Jeff-Birt/TRS-80_M100_SRAM_Tester/Chip_Numbers.JPG

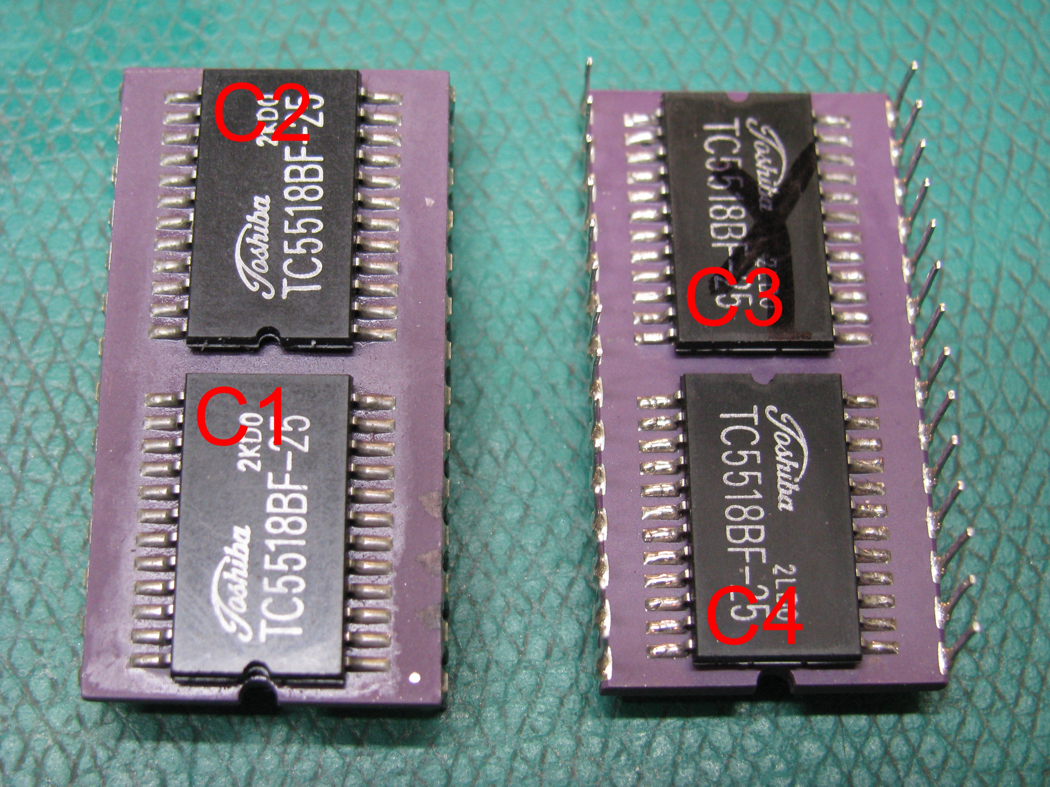
Chip_Numbers.JPG
