Jeff-Birt/TRS-80_M100_SRAM_Tester/README.md

# TRS-80_M100_SRAM_Tester
Uses an Arduino Mega to test TRS-80 SRAM modules.

Not only useful for the intended purpose but can also be used as a template for
building a test fixture for other devices. Demonstrates a basic user interface
using three push buttons and OLED display. Shows Ardunio Port/Pin manipualtion
done by abstracting the bit twiddling functions.

This is hardware released into the public domain.

Anyone is free to copy, modify, use, sell products made from this design.
Please be nice attribute the design to its source, i.e. HEY_BIRT!
If you offer it for sale do so at a reasonable price, don't gouge
folks for somethig you did not design.

THE DESIGN IS PROVIDED "AS IS", WITHOUT WARRANTY OF ANY KIND,
EXPRESS OR IMPLIED, INCLUDING BUT NOT LIMITED TO THE WARRANTIES OF
MERCHANTABILITY, FITNESS FOR A PARTICULAR PURPOSE AND NONINFRINGEMENT.
IN NO EVENT SHALL THE AUTHORS BE LIABLE FOR ANY CLAIM, DAMAGES OR
OTHER LIABILITY, WHETHER IN AN ACTION OF CONTRACT, TORT OR OTHERWISE,
ARISING FROM, OUT OF OR IN CONNECTION WITH THE SOFTWARE OR THE USE OR
OTHER DEALINGS IN THE SOFTWARE.
