Jeff-Birt/TRS-80_M100_SRAM_Tester/Arduino MEGA Tester Schematic/TRS-80_M100_SRAM_Module_Tester_Schematic.pdf

# DC-DC Converter

GND V⁺ | +5V -5V

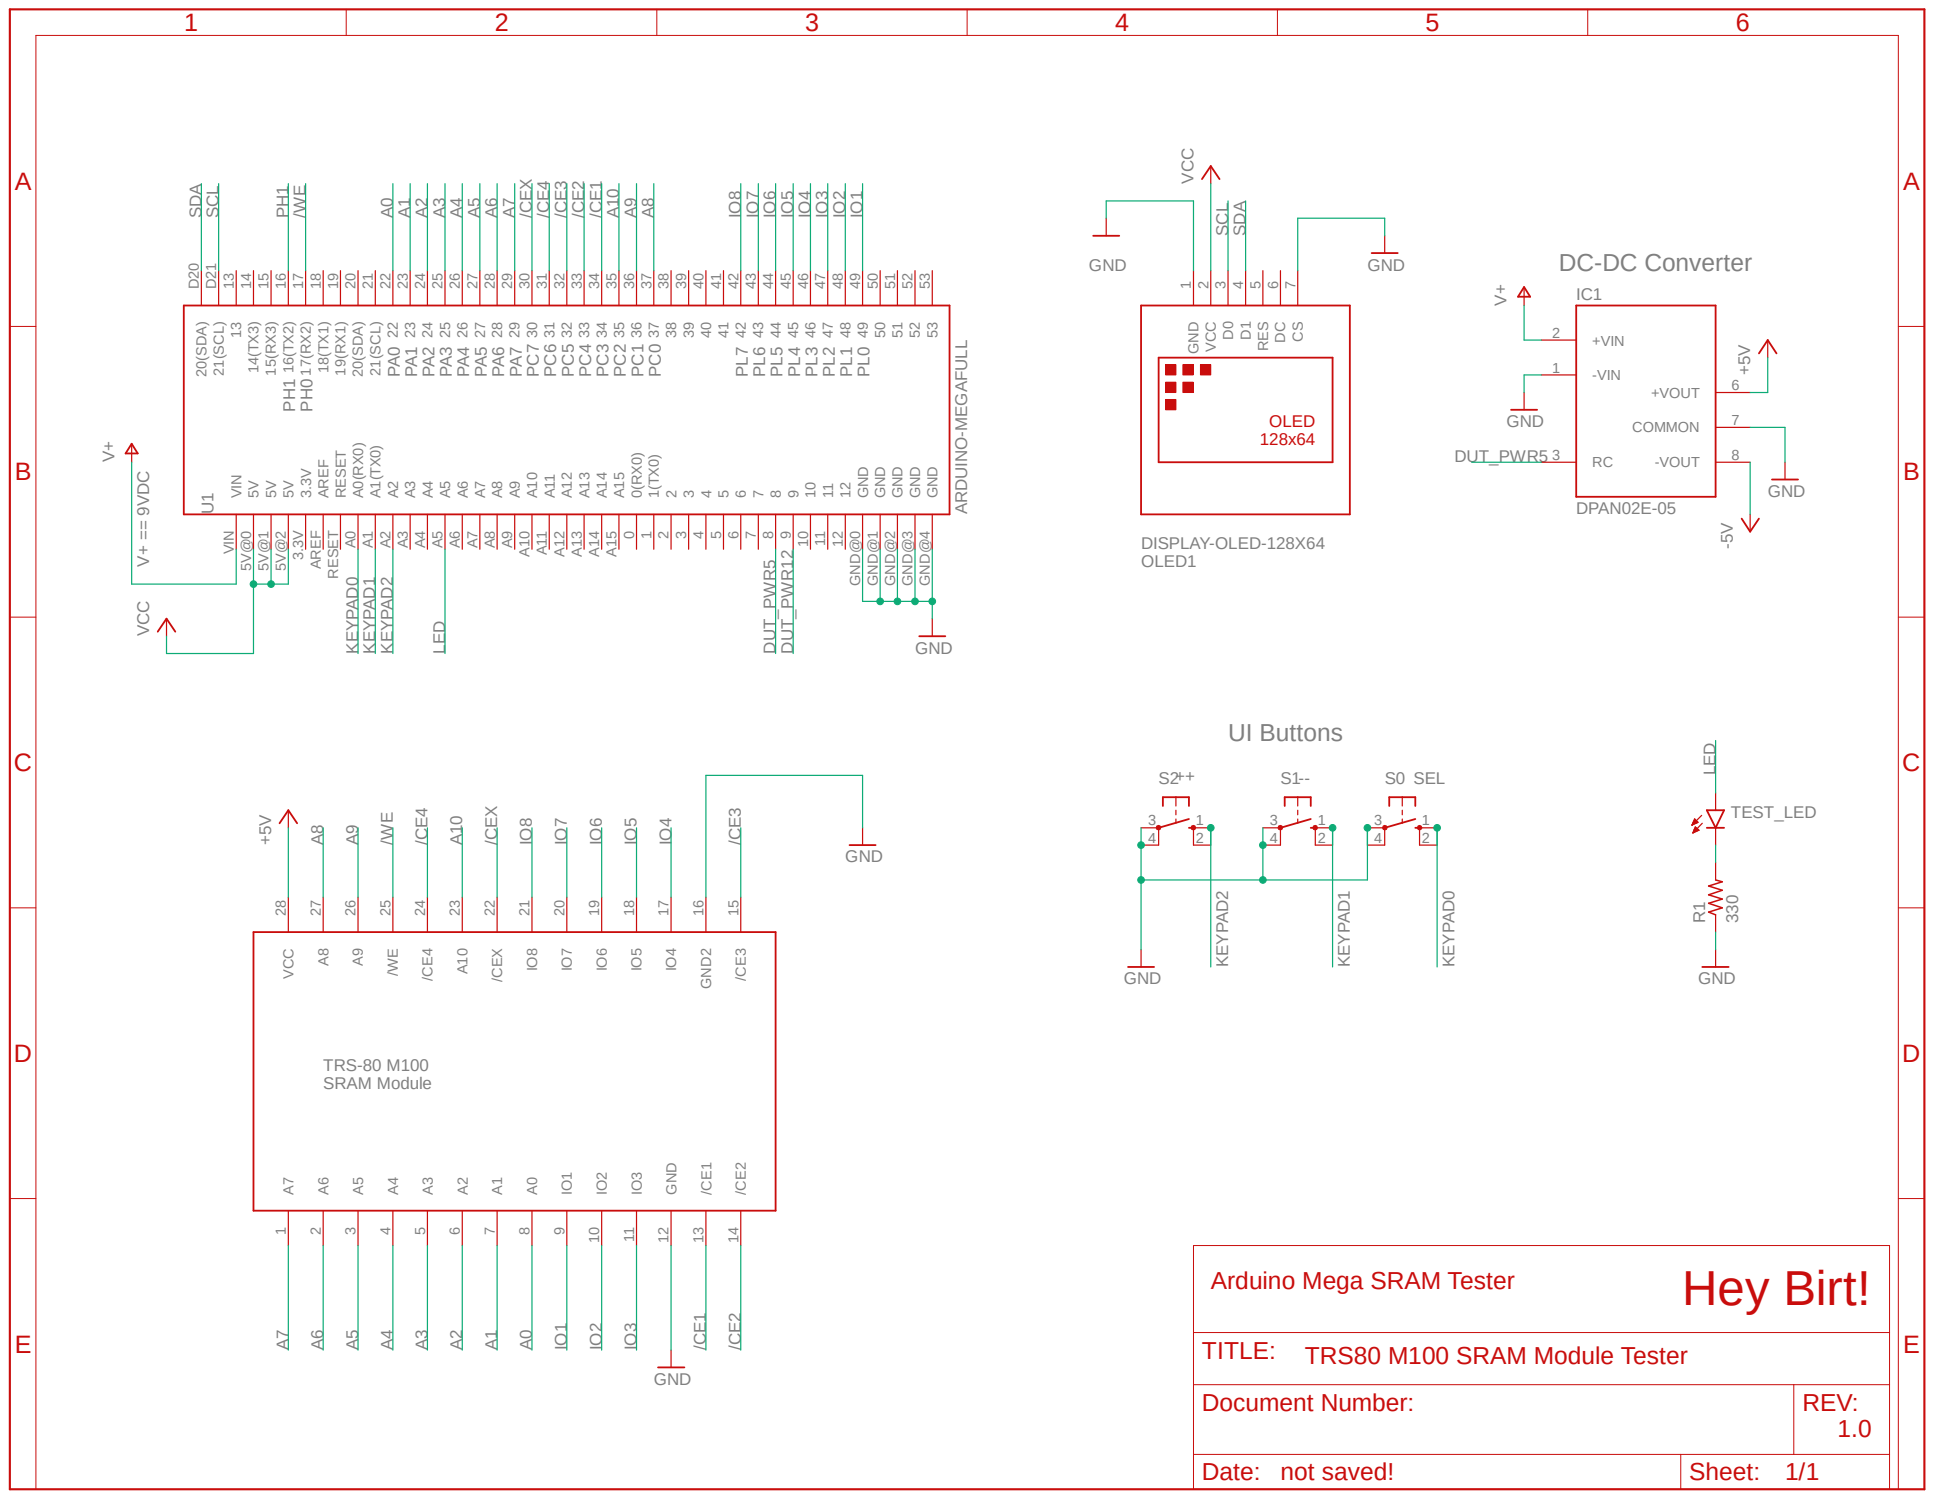
[picture p2: page 1]
TRS-80 M100 SRAM Module; UI Buttons; DPAN02E-05; GND; GND V⁺; VCC; DISPLAY-OLED-128X64; SEL ARDUINO⁻MEGAFULL; GND ⁺⁵V; TEST_LED 330 V⁺ == 9VDC; PA⁰ PA¹ PA² PA³ PA⁴ PA⁵ PA⁶ PA⁷ PC⁷ PC⁶ PC⁵ PC⁴ PC³ PC² PC¹ PC⁰; PL7 PL6 PL5 PL4 PL3 PL2 PL1 PL0 PH¹ PH⁰; -VIN 1; +VIN 2; -VOUT; 8 +VOUT; COMMON; IC1 GND; 1 VCC; 4 RES; 7 OLED1; RESET RESET 5V 5V@¹; A⁰⁽RX⁰⁾ A⁰ A¹⁽TX⁰⁾ A¹ A² A² A³ A³ A⁴ A⁴ A⁵ A⁵ A⁶ A⁶ A⁷ A⁷ A⁸ A⁸ A⁹ A⁹ A¹⁰ A¹⁰ A¹¹ A¹¹ A¹² A¹² A¹³ A¹³ A¹⁴ A¹⁴ A¹⁵ A¹⁵; 1⁽TX⁰⁾ 1; DUT_PWR5 DUT_PWR¹²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

9 IO2 10 IO3 11 GND 12 /CE1 13 /CE2 14 R1 A0 A0 A1 A1 A8 A8 A2 A4A2 A4A6 A6 /CE4 /CE4 A3 A3 A5 A5 A7 A7 /CEX /CEX SCLSCL IO2 IO2 IO1 IO1 SDASDA IO3 IO3 IO4 IO4 IO5 IO5 IO6 IO6 IO7 IO7 A9 A9 A10 A10 /CE1 /CE1 /CE2 /CE2 /CE3 /CE3 PH1 IO8 IO8 DUT_PWR5

9 10 10 GND GND@4 16(TX2) 16 17(RX2) 17 18(TX1) 18 22 22 23 23 24 24 25 25 26 26 27 27 28 28 29 29 30 30 31 31 32 32 33 33 34 34 35 35 36 36 37 37 38 38 40 40 39 39 41 41 42 42 43 43 44 44 45 45 46 46 47 47 48 48 11 11 12 12 13 13 15(RX3) 15 14(TX3) 14 GND GND@0 GND GND@1 GND GND@2 GND GND@3 53 53 52 52 51 51 50 50 49 49 5V 5V@2 3.3V 3.3V AREF AREF 21(SCL) 21 20(SDA) 20 19(RX1) 19 VIN VIN 0(RX0) 0 21(SCL) D21 20(SDA) D20 U1 VCC 28 A8 27 A9 26 /WE 25 /CE4 24 A10 23 /CEX 22 IO8 21 IO7 20 IO6 19 IO5 18 IO4 17 GND2 16 /CE3 15 A7

Arduino Mega SRAM Tester

TRS80 M100 SRAM Module Tester

Document Number: | REV: 1.0

Date: not saved! | Sheet: 1/1
