Jeff-Birt/TRS-80_M100_SRAM_Tester/Arduino MEGA Tester Schematic/Arduino Mega SRAM Tester.sch

## EAGLE design Arduino MEGA Tester Schematic/Arduino Mega SRAM Tester.sch (2020-12-25)

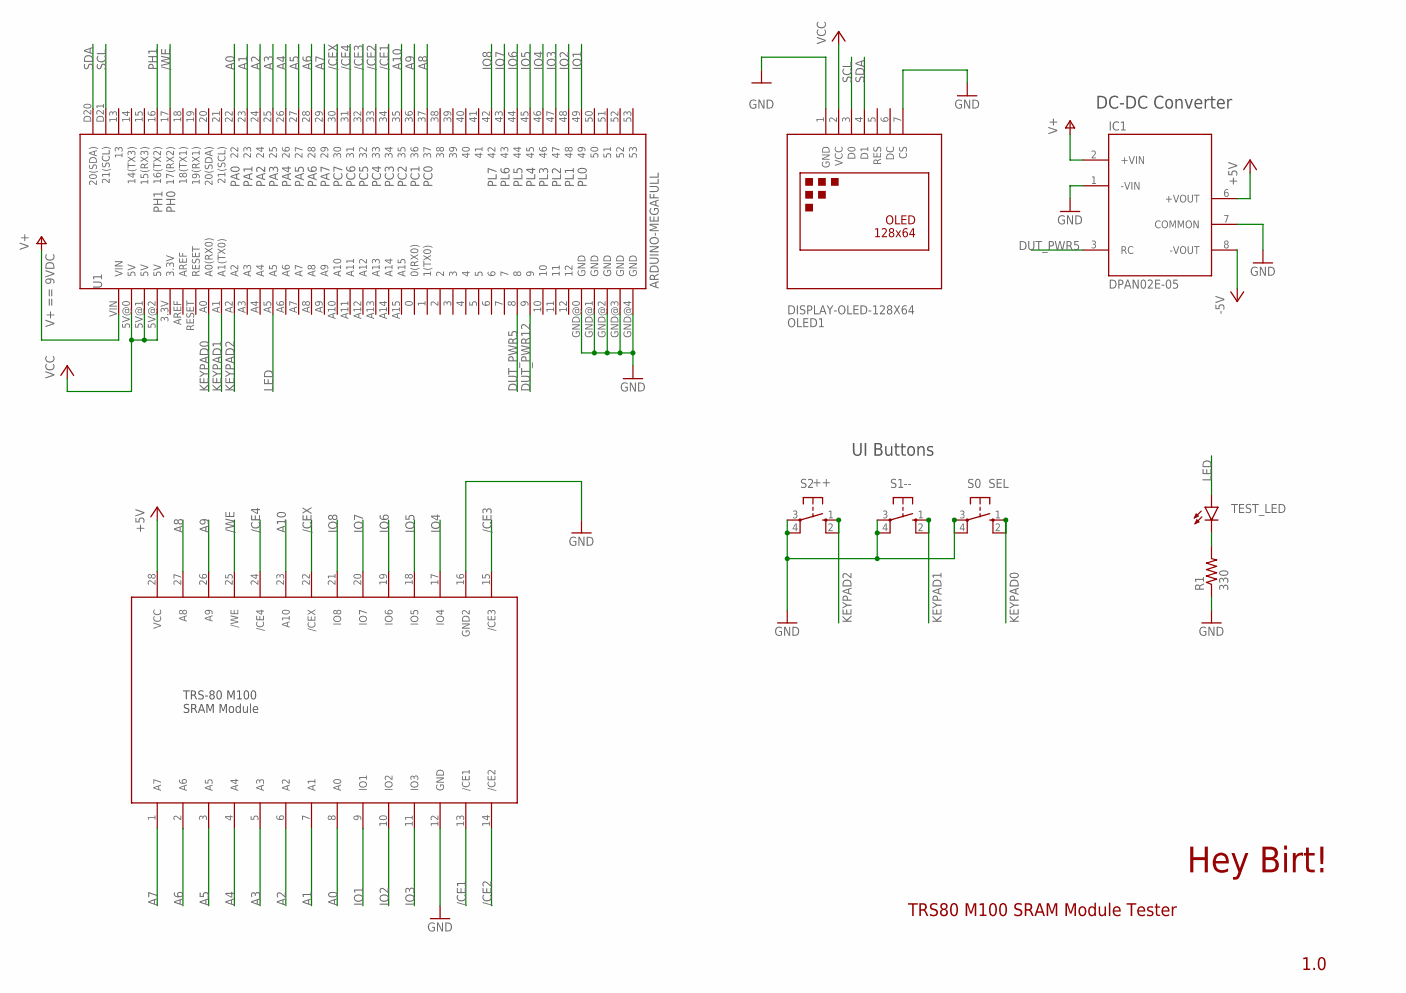
[picture p3: schematic Arduino Mega SRAM Tester.sch]

Parts:
IC1: DPAN02E-05; SIP7
LED1: TEST_LED; LED3MM
OLED1: DISPLAY-OLED-128X64
R1: 330; 0411/15
S0: SEL; B3F-10XX
S1: --; B3F-10XX
S2: ++; B3F-10XX
U1: ARDUINO-MEGAFULL; ARDUINO_MEGA
U$2: M100_SRAMDIL0.7; DIL28-6

Connections:
+5V: IC1.6 (+VOUT), U$2.28 (VCC)
-5V: IC1.8 (-VOUT)
/CE1: U1.34, U$2.13 (/CE1)
/CE2: U1.33, U$2.14 (/CE2)
/CE3: U1.32, U$2.15 (/CE3)
/CE4: U1.31, U$2.24 (/CE4)
/CEX: U1.30, U$2.22 (/CEX)
/WE: U1.17 (17(RX2)), U$2.25 (/WE)
A0: U1.22, U$2.8 (A0)
A1: U1.23, U$2.7 (A1)
A2: U1.24, U$2.6 (A2)
A3: U1.25, U$2.5 (A3)
A4: U1.26, U$2.4 (A4)
A5: U1.27, U$2.3 (A5)
A6: U1.28, U$2.2 (A6)
A7: U1.29, U$2.1 (A7)
A8: U1.37, U$2.27 (A8)
A9: U1.36, U$2.26 (A9)
A10: U1.35, U$2.23 (A10)
DUT_PWR5: IC1.3 (RC), U1.8
DUT_PWR12: U1.9
GND: IC1.1 (-VIN), IC1.7 (COMMON), OLED1.1 (GND), OLED1.7 (CS), R1.1, S0.3, S0.4 (P1), S1.3, S1.4 (P1), S2.3, S2.4 (P1), U1.GND@0 (GND), U1.GND@1 (GND), U1.GND@2 (GND), U1.GND@3 (GND), U1.GND@4 (GND), U$2.12 (GND), U$2.16 (GND2)
IO1: U1.49, U$2.9 (IO1)
IO2: U1.48, U$2.10 (IO2)
IO3: U1.47, U$2.11 (IO3)
IO4: U1.46, U$2.17 (IO4)
IO5: U1.45, U$2.18 (IO5)
IO6: U1.44, U$2.19 (IO6)
IO7: U1.43, U$2.20 (IO7)
IO8: U1.42, U$2.21 (IO8)
KEYPAD0: S0.1 (S), S0.2 (S1), U1.A0 (A0(RX0))
KEYPAD1: S1.1 (S), S1.2 (S1), U1.A1 (A1(TX0))
KEYPAD2: S2.1 (S), S2.2 (S1), U1.A2
LED: LED1.A, U1.A5
unnamed: LED1.K (C), R1.2
PH1: U1.16 (16(TX2))
SCL: OLED1.3 (D0), U1.D21 (21(SCL))
SDA: OLED1.4 (D1), U1.D20 (20(SDA))
V+: IC1.2 (+VIN), U1.VIN
VCC: OLED1.2 (VCC), U1.5V@0 (5V), U1.5V@1 (5V), U1.5V@2 (5V)

Notes on the sheet:
V+ == 9VDC
PA0
PA1
PA2
PA3
PA4
PA5
PA6
PA7
PC7
PC6
PC5
PC4
PC3
PC2
PC1
PC0
PL7
PL6
PL5
PL4
PL3
PL2
PL1
PL0
PH0
PH1
TRS-80 M100 SRAM Module
TRS80 M100 SRAM Module Tester
1.0
UI Buttons
DC-DC Converter
Hey Birt!
